molnarkares/blackmagic/README

See https://github.com/blacksphere/blackmagic/wiki
