molnarkares/blackmagic/hardware/contrib/lyorak/Parts.md

Ref Name|Qty|Component|Value|Package|Order ID|
| --- | --- | --- | --- | --- | --- |
LED4|1|1206-LED||SML|KP-3216SGD (KIN) RoHS 1206 3.2x1.6mm GRE|
LED2|1|1206-LED||SML|KP-3216ID (KIN) RoHS 1206 3.2x1.6mm RED|
LED1|1|1206-LED||SML|KP-3216YD (KIN) RoHS 1206 3.2x1.6mm YEL|
LED0|1|1206-LED||SML|KP-3216YD (KIN) RoHS 1206 3.2x1.6mm YEL|
U6|1|66226-006||CON6_1X6_U_FCI||
J13|1|5103309-1||con10_2X5_S4||
Q2|1|ABM3-8||SM|ABM3-8.000MHZ-D2Y-T|
C18|1|CAPACITOR-1206|1u|1206-CAP|CC1206KKX7R7BB105 (YAG) RoHS 1uF 10% 16V X7R|
C13|1|CAPACITOR-1206|4u7|1206-CAP|CL31B475KAHNNNE (SAM) RoHS 4.7uF 10% 25V|
C16|1|CAPACITOR-1206|10n|1206-CAP|CC1206KRX7R9BB104|
C21|1|CAPACITOR-1206|18p|1206-CAP|CL31C180JBCNNNC (SAM) RoHS 18pF 5% 50V NP0|
C20|1|CAPACITOR-1206|18p|1206-CAP|CL31C180JBCNNNC (SAM) RoHS 18pF 5% 50V NP0|
C15|1|CAPACITOR-1206|100n|1206-CAP|CC1206KRX7R9BB104|
C10|1|CAPACITOR-1206|100n|1206-CAP|CC1206KRX7R9BB104|
C12|1|CAPACITOR-1206|100n|1206-CAP|CC1206KRX7R9BB104|
C14|1|CAPACITOR-1206|100n|1206-CAP|CC1206KRX7R9BB104|
C6|1|CAPACITOR-1206|100n|1206-CAP|CC1206KRX7R9BB104|
C2|1|CAPACITOR-1206|100n|1206-CAP|CC1206KRX7R9BB104|
C1|1|CAPACITOR-1206|100n|1206-CAP|CC1206KRX7R9BB104|
J5|1|CONN_3-1|CONN_3-1|SIP1X3_100||
U2|1|IRLML5103TRPBF||SOT-23-L|SI2307CDS-T1-GE3 (VIS) RoHS SOT-23|
U3|1|LP5951MF-3.3||MF05A|LP5951MF-3.3|
J3|1|MINIJTAG||SM||
R23|1|RESISTOR-1206|1K5|1206-RES|CR-06JL7---1K5 (VIK) RoHS 1K50 5%|
R26|1|RESISTOR-1206|4k7|1206-RES|CR-06JL7---4K7 (VIK) RoHS 4K70 5%|
R1|1|RESISTOR-1206|4k7|1206-RES|CR-06JL7---4K7 (VIK) RoHS 4K70 5%|
R24|1|RESISTOR-1206|10k|1206-RES|CR-06JL7---10K (VIK) RoHS 10K0 5%|
R25|1|RESISTOR-1206|10k|1206-RES|CR-06JL7---10K (VIK) RoHS 10K0 5%|
R27|1|RESISTOR-1206|10k|1206-RES|CR-06JL7---10K (VIK) RoHS 10K0 5%|
R3|1|RESISTOR-1206|10k|1206-RES|CR-06JL7---10K (VIK) RoHS 10K0 5%|
R18|1|RESISTOR-1206|22R|1206-RES|CR-06JL7---22R (VIK) RoHS 22R0 5%|
R20|1|RESISTOR-1206|22R|1206-RES|CR-06JL7---22R (VIK) RoHS 22R0 5%|
R6|1|RESISTOR-1206|120R|1206-RES|CR-06JL7--120R (VIK) RoHS 120R 5%|
R15|1|RESISTOR-1206|390R|1206-RES|CR-06JL7--390R (VIK) RoHS 390R 5%|
R12|1|RESISTOR-1206|390R|1206-RES|CR-06JL7--390R (VIK) RoHS 390R 5%|
R14|1|RESISTOR-1206|390R|1206-RES|CR-06JL7--390R (VIK) RoHS 390R 5%|
R13|1|RESISTOR-1206|390R|1206-RES|CR-06JL7--390R (VIK) RoHS 390R 5%|
SW1|1|SMT2PSWITCH||Q_SIL|DTSM-32S-B|
SW2|1|SMT2PSWITCH||Q_SIL|DTSM-32S-B|
U4|1|SN65HV232||sm|SN65HVD232QD|
JP1|1|SQ_JMP-0402|0/DNP|0402-SQJMP|on PCB|
U5|1|STM32-C-64|STM32F105RCT6|LQFP64|STM32F105RCT6|
U1|1|TXS0108EPWRG4||PW20-L|TXS0108EPWR|
USB|1|ZX62-B-5PA|ZX62-B-5PA|ZX62-B-5PA|ZX62D-B-5PA8|
