molnarkares/blackmagic/hardware/contrib/lyorak/blackmagic_lyorak.pdf

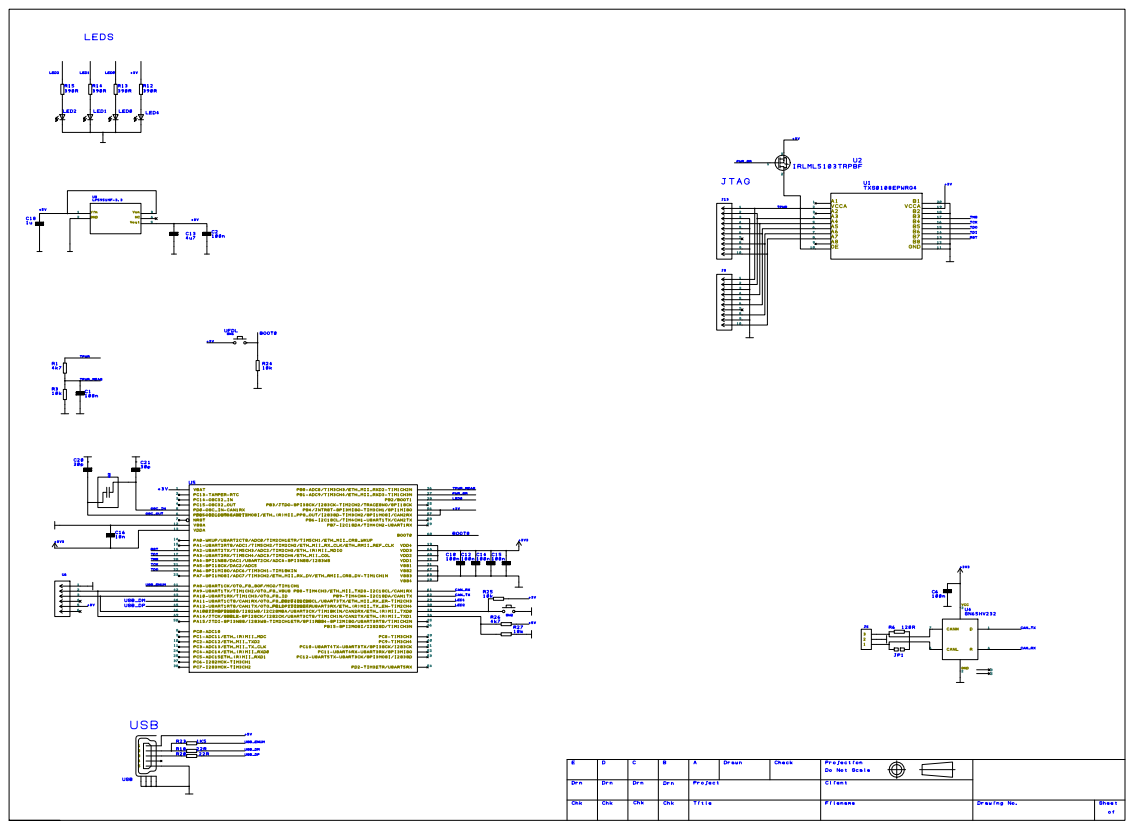
[picture p4: page 1]
