molnarkares/blackmagic/(list of files, drawings)

Other design files:
hardware/contrib/lyorak/blackmagic.pcb
