molnarkares/blackmagic/src/platforms/f4discovery/platform.h

/*
 * This file is part of the Black Magic Debug project.
 *
 * Copyright (C) 2011  Black Sphere Technologies Ltd.
 * Written by Gareth McMullin <gareth@blacksphere.co.nz>
 *
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
 * You should have received a copy of the GNU General Public License
 * along with this program.  If not, see <http://www.gnu.org/licenses/>.
 */

/* This file implements the platform specific functions for the STM32
 * implementation.
 */
#ifndef __PLATFORM_H
#define __PLATFORM_H

#include <stdint.h>
#include <libopencm3/cm3/common.h>
#include <libopencm3/stm32/f4/memorymap.h>
#include <libopencm3/stm32/f4/gpio.h>
#include <libopencm3/usb/usbd.h>

#include <setjmp.h>
#include <alloca.h>

#include "gdb_packet.h"

#define INLINE_GPIO
#define CDCACM_PACKET_SIZE 	64
#define PLATFORM_HAS_TRACESWO
#define BOARD_IDENT       "Black Magic Probe (F4Discovery), (Firmware 1.5" VERSION_SUFFIX ", build " BUILDDATE ")"
#define BOARD_IDENT_DFU   "Black Magic (Upgrade) for F4Discovery, (Firmware 1.5" VERSION_SUFFIX ", build " BUILDDATE ")"
#define DFU_IDENT         "Black Magic Firmware Upgrade (F4Discovery"
#define DFU_IFACE_STRING  "@Internal Flash   /0x08000000/1*016Ka,3*016Kg,1*064Kg,7*128Kg"

extern usbd_device *usbdev;
#define CDCACM_GDB_ENDPOINT	1
#define CDCACM_UART_ENDPOINT	3

/* Important pin mappings for STM32 implementation:
 *
 * LED0 = 	PD12	(Green  LED : Running)
 * LED1 = 	PD13	(Orange LED : Idle)
 * LED2 = 	PD12	(Red LED    : Error)
 * LED3 = 	PD15	(Blue LED   : Bootloader active)
 *
 * TPWR = 	XXX (input) -- analogue on mini design ADC1, ch8
 * nTRST = 	PC1
 * SRST_OUT =   PC8
 * TDI = 	PC2
 * TMS = 	PC4 (input for SWDP)
 * TCK = 	PC5/SWCLK
 * TDO = 	PC6 (input for TRACESWO
 * nSRST =
 *
 * USB cable pull-up: PA8
 * USB VBUS detect:  PB13 -- New on mini design.
 *                           Enable pull up for compatibility.
 * Force DFU mode button: PB12
 */

/* Hardware definitions... */
#define JTAG_PORT 	GPIOC
#define TDI_PORT	JTAG_PORT
#define TMS_PORT	JTAG_PORT
#define TCK_PORT	JTAG_PORT
#define TDO_PORT	GPIOC
#define TDI_PIN		GPIO2
#define TMS_PIN		GPIO4
#define TCK_PIN		GPIO5
#define TDO_PIN		GPIO6

#define SWDIO_PORT 	JTAG_PORT
#define SWCLK_PORT 	JTAG_PORT
#define SWDIO_PIN	TMS_PIN
#define SWCLK_PIN	TCK_PIN

#define TRST_PORT	GPIOC
#define TRST_PIN	GPIO1
#define SRST_PORT	GPIOC
#define SRST_PIN	GPIO8

#define LED_PORT	GPIOD
#define LED_PORT_UART	GPIOD
#define LED_UART	GPIO12
#define LED_IDLE_RUN	GPIO13
#define LED_ERROR	GPIO14
#define LED_BOOTLOADER	GPIO15

#define TMS_SET_MODE() \
	gpio_mode_setup(TMS_PORT, GPIO_MODE_OUTPUT, \
	                GPIO_PUPD_NONE, TMS_PIN);
#define SWDIO_MODE_FLOAT() \
	gpio_mode_setup(SWDIO_PORT, GPIO_MODE_INPUT, \
	                GPIO_PUPD_NONE, SWDIO_PIN);

#define SWDIO_MODE_DRIVE() \
	gpio_mode_setup(SWDIO_PORT, GPIO_MODE_OUTPUT, \
	                GPIO_PUPD_NONE, SWDIO_PIN);


#define USB_DRIVER      stm32f107_usb_driver
#define USB_IRQ         NVIC_OTG_FS_IRQ
#define USB_ISR         otg_fs_isr
/* Interrupt priorities.  Low numbers are high priority.
 * For now USART1 preempts USB which may spin while buffer is drained.
 * TIM3 is used for traceswo capture and must be highest priority.
 */
#define IRQ_PRI_USB		(2 << 4)
#define IRQ_PRI_USBUSART	(1 << 4)
#define IRQ_PRI_USBUSART_TIM	(3 << 4)
#define IRQ_PRI_TRACE		(0 << 4)

#define USBUSART USART3
#define USBUSART_CR1 USART3_CR1
#define USBUSART_IRQ NVIC_USART3_IRQ
#define USBUSART_CLK RCC_USART3
#define USBUSART_TX_PORT GPIOD
#define USBUSART_TX_PIN  GPIO8
#define USBUSART_RX_PORT GPIOD
#define USBUSART_RX_PIN  GPIO9
#define USBUSART_ISR usart3_isr
#define USBUSART_TIM TIM4
#define USBUSART_TIM_CLK_EN() rcc_periph_clock_enable(RCC_TIM4)
#define USBUSART_TIM_IRQ NVIC_TIM4_IRQ
#define USBUSART_TIM_ISR tim4_isr

#define UART_PIN_SETUP() do { \
	gpio_mode_setup(USBUSART_TX_PORT, GPIO_MODE_AF, GPIO_PUPD_NONE, \
	                USBUSART_TX_PIN); \
	gpio_mode_setup(USBUSART_RX_PORT, GPIO_MODE_AF, GPIO_PUPD_NONE, \
	                USBUSART_RX_PIN); \
	gpio_set_af(USBUSART_TX_PORT, GPIO_AF7, USBUSART_TX_PIN); \
	gpio_set_af(USBUSART_RX_PORT, GPIO_AF7, USBUSART_RX_PIN); \
    } while(0)

#define TRACE_TIM TIM3
#define TRACE_TIM_CLK_EN() rcc_periph_clock_enable(RCC_TIM3)
#define TRACE_IRQ   NVIC_TIM3_IRQ
#define TRACE_ISR   tim3_isr

#define DEBUG(...)

extern uint8_t running_status;
extern volatile uint32_t timeout_counter;

extern jmp_buf fatal_error_jmpbuf;

extern const char *morse_msg;

#define gpio_set_val(port, pin, val) do {	\
	if(val)					\
		gpio_set((port), (pin));	\
	else					\
		gpio_clear((port), (pin));	\
} while(0)

#define SET_RUN_STATE(state)	{running_status = (state);}
#define SET_IDLE_STATE(state)	{gpio_set_val(LED_PORT, LED_IDLE_RUN, state);}
#define SET_ERROR_STATE(state)	{gpio_set_val(LED_PORT, LED_ERROR, state);}

#define PLATFORM_SET_FATAL_ERROR_RECOVERY()	{setjmp(fatal_error_jmpbuf);}
#define PLATFORM_FATAL_ERROR(error)	{ 		\
	if(running_status) gdb_putpacketz("X1D");	\
		else gdb_putpacketz("EFF");		\
	running_status = 0;				\
	target_list_free();				\
	morse("TARGET LOST.", 1);			\
	longjmp(fatal_error_jmpbuf, (error));		\
}

int platform_init(void);
void morse(const char *msg, char repeat);
const char *platform_target_voltage(void);
void platform_delay(uint32_t delay);
static inline int platform_hwversion(void)
{
	return 0;
}

/* <cdcacm.c> */
void cdcacm_init(void);
/* Returns current usb configuration, or 0 if not configured. */
int cdcacm_get_config(void);
int cdcacm_get_dtr(void);

/* <platform.h> */
void uart_usb_buf_drain(uint8_t ep);

/* Use newlib provided integer only stdio functions */
#define sscanf siscanf
#define sprintf siprintf
#define vasprintf vasiprintf

#ifdef INLINE_GPIO
static inline void _gpio_set(uint32_t gpioport, uint16_t gpios)
{
	GPIO_BSRR(gpioport) = gpios;
	GPIO_BSRR(gpioport) = gpios;
}
#define gpio_set _gpio_set

static inline void _gpio_clear(uint32_t gpioport, uint16_t gpios)
{
	GPIO_BSRR(gpioport) = gpios<<16;
	GPIO_BSRR(gpioport) = gpios<<16;
}
#define gpio_clear _gpio_clear

static inline uint16_t _gpio_get(uint32_t gpioport, uint16_t gpios)
{
	return (uint16_t)GPIO_IDR(gpioport) & gpios;
}
#define gpio_get _gpio_get
#endif

#endif

#define disconnect_usb() do {usbd_disconnect(usbdev,1); nvic_disable_irq(USB_IRQ);} while(0)
void assert_boot_pin(void);
#define setup_vbus_irq()
