molnarkares/blackmagic/src/platforms/stm32/dfucore.c

/*
 * This file is part of the Black Magic Debug project.
 *
 * Copyright (C) 2013 Gareth McMullin <gareth@blacksphere.co.nz>
 *
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
 * You should have received a copy of the GNU General Public License
 * along with this program.  If not, see <http://www.gnu.org/licenses/>.
 */

#include "platform.h"

#include <string.h>
#include <libopencm3/stm32/flash.h>
#include <libopencm3/usb/usbd.h>
#include <libopencm3/usb/dfu.h>

#include "usbdfu.h"

usbd_device *usbdev;
/* We need a special large control buffer for this device: */
uint8_t usbd_control_buffer[2048];

static uint32_t max_address;

static enum dfu_state usbdfu_state = STATE_DFU_IDLE;

static char *get_dev_unique_id(char *serial_no);

static struct {
	uint8_t buf[sizeof(usbd_control_buffer)];
	uint16_t len;
	uint32_t addr;
	uint16_t blocknum;
} prog;

const struct usb_device_descriptor dev = {
	.bLength = USB_DT_DEVICE_SIZE,
	.bDescriptorType = USB_DT_DEVICE,
	.bcdUSB = 0x0200,
	.bDeviceClass = 0,
	.bDeviceSubClass = 0,
	.bDeviceProtocol = 0,
	.bMaxPacketSize0 = 64,
	.idVendor = 0x1D50,
	.idProduct = 0x6017,
	.bcdDevice = 0x0100,
	.iManufacturer = 1,
	.iProduct = 2,
	.iSerialNumber = 3,
	.bNumConfigurations = 1,
};

const struct usb_dfu_descriptor dfu_function = {
	.bLength = sizeof(struct usb_dfu_descriptor),
	.bDescriptorType = DFU_FUNCTIONAL,
	.bmAttributes = USB_DFU_CAN_DOWNLOAD | USB_DFU_WILL_DETACH,
	.wDetachTimeout = 255,
	.wTransferSize = 2048,
	.bcdDFUVersion = 0x011A,
};

const struct usb_interface_descriptor iface = {
	.bLength = USB_DT_INTERFACE_SIZE,
	.bDescriptorType = USB_DT_INTERFACE,
	.bInterfaceNumber = 0,
	.bAlternateSetting = 0,
	.bNumEndpoints = 0,
	.bInterfaceClass = 0xFE, /* Device Firmware Upgrade */
	.bInterfaceSubClass = 1,
	.bInterfaceProtocol = 2,

	/* The ST Microelectronics DfuSe application needs this string.
	 * The format isn't documented... */
	.iInterface = 4,

	.extra = &dfu_function,
	.extralen = sizeof(dfu_function),
};

const struct usb_interface ifaces[] = {{
	.num_altsetting = 1,
	.altsetting = &iface,
}};

const struct usb_config_descriptor config = {
	.bLength = USB_DT_CONFIGURATION_SIZE,
	.bDescriptorType = USB_DT_CONFIGURATION,
	.wTotalLength = 0,
	.bNumInterfaces = 1,
	.bConfigurationValue = 1,
	.iConfiguration = 0,
	.bmAttributes = 0xC0,
	.bMaxPower = 0x32,

	.interface = ifaces,
};

static char serial_no[9];

/*static const char *usb_strings[] = {
	"Lyorak",
	BOARD_IDENT_DFU,
	"Papilot",
	serial_no,
	//This string is used by ST Microelectronics' DfuSe utility
	"@Internal Flash   /0x08000000/4*002Ka,124*002Kg"
};*/

static const char *usb_strings[] = {
	"Black Sphere Technologies",
	BOARD_IDENT_DFU,
	serial_no,
	// This string is used by ST Microelectronics' DfuSe utility
	DFU_IFACE_STRING
};

static const char *usb_strings_upd[] = {
	"Black Sphere Technologies",
	BOARD_IDENT_UPD,
	serial_no,
	/* This string is used by ST Microelectronics' DfuSe utility */
	UPD_IFACE_STRING,
};

static uint32_t get_le32(const void *vp)
{
	const uint8_t *p = vp;
	return ((uint32_t)p[3] << 24) + ((uint32_t)p[2] << 16) + (p[1] << 8) + p[0];
}

static uint8_t usbdfu_getstatus(uint32_t *bwPollTimeout)
{
	switch(usbdfu_state) {
	case STATE_DFU_DNLOAD_SYNC:
		usbdfu_state = STATE_DFU_DNBUSY;
		*bwPollTimeout = dfu_poll_timeout(prog.buf[0],
					get_le32(prog.buf + 1),
					prog.blocknum);
		return DFU_STATUS_OK;

	case STATE_DFU_MANIFEST_SYNC:
		/* Device will reset when read is complete */
		usbdfu_state = STATE_DFU_MANIFEST;
		return DFU_STATUS_OK;

	default:
		return DFU_STATUS_OK;
	}
}

static void
usbdfu_getstatus_complete(usbd_device *dev, struct usb_setup_data *req)
{
	(void)req;

	switch(usbdfu_state) {
	case STATE_DFU_DNBUSY:

		flash_unlock();
		if(prog.blocknum == 0) {
			uint32_t addr = get_le32(prog.buf + 1);
			if ((addr < app_address) || (addr >= max_address)) {
				flash_lock();
				usbd_ep_stall_set(dev, 0, 1);
				return;
			}
			switch(prog.buf[0]) {
			case CMD_ERASE:
				dfu_check_and_do_sector_erase(addr);
			case CMD_SETADDR:
				prog.addr = addr;
			}
		} else {
			uint32_t baseaddr = prog.addr +
				((prog.blocknum - 2) *
					dfu_function.wTransferSize);
			dfu_flash_program_buffer(baseaddr, prog.buf, prog.len);
		}
		flash_lock();

		/* We jump straight to dfuDNLOAD-IDLE,
		 * skipping dfuDNLOAD-SYNC
		 */
		usbdfu_state = STATE_DFU_DNLOAD_IDLE;
		return;

	case STATE_DFU_MANIFEST:
		dfu_detach();
		return; /* Will never return */
	default:
		return;
	}
}

static int usbdfu_control_request(usbd_device *dev,
		struct usb_setup_data *req, uint8_t **buf, uint16_t *len,
		void (**complete)(usbd_device *dev, struct usb_setup_data *req))
{
	(void)dev;

	if((req->bmRequestType & 0x7F) != 0x21)
		return 0; /* Only accept class request */

	switch(req->bRequest) {
	case DFU_DNLOAD:
		if((len == NULL) || (*len == 0)) {
			usbdfu_state = STATE_DFU_MANIFEST_SYNC;
			return 1;
		} else {
			/* Copy download data for use on GET_STATUS */
			prog.blocknum = req->wValue;
			prog.len = *len;
			memcpy(prog.buf, *buf, *len);
			usbdfu_state = STATE_DFU_DNLOAD_SYNC;
			return 1;
		}
	case DFU_CLRSTATUS:
		/* Clear error and return to dfuIDLE */
		if(usbdfu_state == STATE_DFU_ERROR)
			usbdfu_state = STATE_DFU_IDLE;
		return 1;
	case DFU_ABORT:
		/* Abort returns to dfuIDLE state */
		usbdfu_state = STATE_DFU_IDLE;
		return 1;
	case DFU_UPLOAD:
		/* Upload not supported for now */
		return 0;
	case DFU_GETSTATUS: {
		uint32_t bwPollTimeout = 0; /* 24-bit integer in DFU class spec */

		(*buf)[0] = usbdfu_getstatus(&bwPollTimeout);
		(*buf)[1] = bwPollTimeout & 0xFF;
		(*buf)[2] = (bwPollTimeout >> 8) & 0xFF;
		(*buf)[3] = (bwPollTimeout >> 16) & 0xFF;
		(*buf)[4] = usbdfu_state;
		(*buf)[5] = 0;	/* iString not used here */
		*len = 6;

		*complete = usbdfu_getstatus_complete;

		return 1;
		}
	case DFU_GETSTATE:
		/* Return state with no state transision */
		*buf[0] = usbdfu_state;
		*len = 1;
		return 1;
	}

	return 0;
}

void dfu_init(const usbd_driver *driver, dfu_mode_t mode)
{
	get_dev_unique_id(serial_no);

	usbdev = usbd_init(driver, &dev, &config,
			   (mode == DFU_MODE)?usb_strings:usb_strings_upd, 4,
			   usbd_control_buffer, sizeof(usbd_control_buffer));

	usbd_register_control_callback(usbdev,
				USB_REQ_TYPE_CLASS | USB_REQ_TYPE_INTERFACE,
				USB_REQ_TYPE_TYPE | USB_REQ_TYPE_RECIPIENT,
				usbdfu_control_request);
}

void dfu_main(void)
{
	while (1) {
		//gpio_set(GPIOB, GPIO10);
		usbd_poll(usbdev);
		//gpio_clear(GPIOB, GPIO10);
	}
}

static char *get_dev_unique_id(char *s)
{
#if defined(STM32F4) || defined(STM32F2)
#	define UNIQUE_SERIAL_R 0x1FFF7A10
#	define FLASH_SIZE_R    0x1fff7A22
#elif defined(STM32F3)
#	define UNIQUE_SERIAL_R 0x1FFFF7AC
#	define FLASH_SIZE_R    0x1fff77cc
#elif defined(STM32L1)
#	define UNIQUE_SERIAL_R 0x1ff80050
#	define FLASH_SIZE_R    0x1FF8004C
#else
#	define UNIQUE_SERIAL_R 0x1FFFF7E8;
#	define FLASH_SIZE_R    0x1ffff7e0
#endif
	volatile uint32_t *unique_id_p = (volatile uint32_t *)UNIQUE_SERIAL_R;
	uint32_t unique_id = *unique_id_p +
			*(unique_id_p + 1) +
			*(unique_id_p + 2);
	int i;

	/* Calculated the upper flash limit from the exported data
	   in theparameter block*/
	max_address = (*(uint32_t *) FLASH_SIZE_R) <<10;
	/* Fetch serial number from chip's unique ID */
	for(i = 0; i < 8; i++) {
		s[7-i] = ((unique_id >> (4*i)) & 0xF) + '0';
	}
	for(i = 0; i < 8; i++)
		if(s[i] > '9')
			s[i] += 'A' - '9' - 1;
	s[8] = 0;

	return s;
}
