molnarkares/blackmagic/src/include/adiv5.h

/*
 * This file is part of the Black Magic Debug project.
 *
 * Copyright (C) 2011  Black Sphere Technologies Ltd.
 * Written by Gareth McMullin <gareth@blacksphere.co.nz>
 *
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
 * You should have received a copy of the GNU General Public License
 * along with this program.  If not, see <http://www.gnu.org/licenses/>.
 */

#ifndef __ADIV5_H
#define __ADIV5_H

#include "general.h"
#include "jtag_scan.h"
#include "target.h"

/* ADIv5 DP Register addresses */
#define ADIV5_DP_IDCODE		0x0
#define ADIV5_DP_ABORT		0x0
#define ADIV5_DP_CTRLSTAT	0x4
#define ADIV5_DP_SELECT		0x8
#define ADIV5_DP_RDBUFF		0xC

/* AP Abort Register (ABORT) */
/* Bits 31:5 - Reserved */
#define ADIV5_DP_ABORT_ORUNERRCLR	(1 << 4)
#define ADIV5_DP_ABORT_WDERRCLR		(1 << 3)
#define ADIV5_DP_ABORT_STKERRCLR	(1 << 2)
#define ADIV5_DP_ABORT_STKCMPCLR	(1 << 1)
/* Bits 5:1 - SW-DP only, reserved in JTAG-DP */
#define ADIV5_DP_ABORT_DAPABORT		(1 << 0)

/* Control/Status Register (CTRLSTAT) */
#define ADIV5_DP_CTRLSTAT_CSYSPWRUPACK	(1u << 31)
#define ADIV5_DP_CTRLSTAT_CSYSPWRUPREQ	(1u << 30)
#define ADIV5_DP_CTRLSTAT_CDBGPWRUPACK	(1u << 29)
#define ADIV5_DP_CTRLSTAT_CDBGPWRUPREQ	(1u << 28)
#define ADIV5_DP_CTRLSTAT_CDBGRSTACK	(1u << 27)
#define ADIV5_DP_CTRLSTAT_CDBGRSTREQ	(1u << 26)
/* Bits 25:24 - Reserved */
/* Bits 23:12 - TRNCNT */
#define ADIV5_DP_CTRLSTAT_TRNCNT
/* Bits 11:8 - MASKLANE */
#define ADIV5_DP_CTRLSTAT_MASKLANE
/* Bits 7:6 - Reserved in JTAG-DP */
#define ADIV5_DP_CTRLSTAT_WDATAERR	(1u << 7)
#define ADIV5_DP_CTRLSTAT_READOK	(1u << 6)
#define ADIV5_DP_CTRLSTAT_STICKYERR	(1u << 5)
#define ADIV5_DP_CTRLSTAT_STICKYCMP	(1u << 4)
#define ADIV5_DP_CTRLSTAT_TRNMODE_MASK	(3u << 2)
#define ADIV5_DP_CTRLSTAT_STICKYORUN	(1u << 1)
#define ADIV5_DP_CTRLSTAT_ORUNDETECT	(1u << 0)


/* ADIv5 MEM-AP Registers */
#define ADIV5_AP_CSW		0x00
#define ADIV5_AP_TAR		0x04
/* 0x08 - Reserved */
#define ADIV5_AP_DRW		0x0C
#define ADIV5_AP_DB(x)		(0x10 + (4*(x)))
/* 0x20:0xF0 - Reserved */
#define ADIV5_AP_CFG		0xF4
#define ADIV5_AP_BASE		0xF8
#define ADIV5_AP_IDR		0xFC

/* AP Control and Status Word (CSW) */
#define ADIV5_AP_CSW_DBGSWENABLE	(1u << 31)
/* Bits 30:24 - Prot, Implementation defined, for Cortex-M3: */
#define ADIV5_AP_CSW_MASTERTYPE_DEBUG	(1u << 29)
#define ADIV5_AP_CSW_HPROT1		(1u << 25)
#define ADIV5_AP_CSW_SPIDEN		(1u << 23)
/* Bits 22:12 - Reserved */
/* Bits 11:8 - Mode, must be zero */
#define ADIV5_AP_CSW_TRINPROG		(1u << 7)
#define ADIV5_AP_CSW_DEVICEEN		(1u << 6)
#define ADIV5_AP_CSW_ADDRINC_NONE	(0u << 4)
#define ADIV5_AP_CSW_ADDRINC_SINGLE	(1u << 4)
#define ADIV5_AP_CSW_ADDRINC_PACKED	(2u << 4)
#define ADIV5_AP_CSW_ADDRINC_MASK	(3u << 4)
/* Bit 3 - Reserved */
#define ADIV5_AP_CSW_SIZE_BYTE		(0u << 0)
#define ADIV5_AP_CSW_SIZE_HALFWORD	(1u << 0)
#define ADIV5_AP_CSW_SIZE_WORD		(2u << 0)
#define ADIV5_AP_CSW_SIZE_MASK		(7u << 0)

/* Constants to make RnW and APnDP parameters more clear in code */
#define ADIV5_LOW_WRITE		0
#define ADIV5_LOW_READ		1
#define ADIV5_LOW_DP		0
#define ADIV5_LOW_AP		1

/* Try to keep this somewhat absract for later adding SW-DP */
typedef struct ADIv5_DP_s {
	int refcnt;

	uint32_t idcode;

	bool allow_timeout;

	void (*dp_write)(struct ADIv5_DP_s *dp, uint8_t addr, uint32_t value);
	uint32_t (*dp_read)(struct ADIv5_DP_s *dp, uint8_t addr);

	uint32_t (*error)(struct ADIv5_DP_s *dp);

	uint32_t (*low_access)(struct ADIv5_DP_s *dp, uint8_t APnDP, uint8_t RnW,
			uint8_t addr, uint32_t value);

	union {
		jtag_dev_t *dev;
		uint8_t fault;
	};
} ADIv5_DP_t;

static inline void adiv5_dp_write(ADIv5_DP_t *dp, uint8_t addr, uint32_t value)
{
	dp->dp_write(dp, addr, value);
}

static inline uint32_t adiv5_dp_read(ADIv5_DP_t *dp, uint8_t addr)
{
	return dp->dp_read(dp, addr);
}

static inline uint32_t adiv5_dp_error(ADIv5_DP_t *dp)
{
	return dp->error(dp);
}

static inline uint32_t adiv5_dp_low_access(struct ADIv5_DP_s *dp, uint8_t APnDP,
					uint8_t RnW, uint8_t addr, uint32_t value)
{
	return dp->low_access(dp, APnDP, RnW, addr, value);
}

typedef struct ADIv5_AP_s {
	int refcnt;

	ADIv5_DP_t *dp;
	uint8_t apsel;

	uint32_t idr;
	uint32_t cfg;
	uint32_t base;
	uint32_t csw;

	void *priv;
	void (*priv_free)(void *);
} ADIv5_AP_t;

void adiv5_dp_init(ADIv5_DP_t *dp);

void adiv5_dp_ref(ADIv5_DP_t *dp);
void adiv5_ap_ref(ADIv5_AP_t *ap);
void adiv5_dp_unref(ADIv5_DP_t *dp);
void adiv5_ap_unref(ADIv5_AP_t *ap);

void adiv5_dp_write_ap(ADIv5_DP_t *dp, uint8_t addr, uint32_t value);
uint32_t adiv5_dp_read_ap(ADIv5_DP_t *dp, uint8_t addr);

uint32_t adiv5_ap_mem_read(ADIv5_AP_t *ap, uint32_t addr);
void adiv5_ap_mem_write(ADIv5_AP_t *ap, uint32_t addr, uint32_t value);
uint16_t adiv5_ap_mem_read_halfword(ADIv5_AP_t *ap, uint32_t addr);
void adiv5_ap_mem_write_halfword(ADIv5_AP_t *ap, uint32_t addr, uint16_t value);
uint8_t adiv5_ap_mem_read_byte(ADIv5_AP_t *ap, uint32_t addr);
void adiv5_ap_mem_write_byte(ADIv5_AP_t *ap, uint32_t addr, uint8_t value);

void adiv5_ap_write(ADIv5_AP_t *ap, uint8_t addr, uint32_t value);
uint32_t adiv5_ap_read(ADIv5_AP_t *ap, uint8_t addr);

void adiv5_jtag_dp_handler(jtag_dev_t *dev);
int adiv5_swdp_scan(void);

static inline ADIv5_AP_t *adiv5_target_ap(target *target)
{
	return target->priv;
}

#endif
