molnarkares/blackmagic/scripts/stm32_mem.py

#!/usr/bin/env python
#
# stm32_mem.py: STM32 memory access using USB DFU class
# Copyright (C) 2011  Black Sphere Technologies 
# Written by Gareth McMullin <gareth@blacksphere.co.nz>
#
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
from time import sleep
import struct
from sys import stdout, argv

import argparse
import usb
import dfu

CMD_GETCOMMANDS =            0x00
CMD_SETADDRESSPOINTER =      0x21
CMD_ERASE =                  0x41

def stm32_erase(dev, addr):
	erase_cmd = struct.pack("<BL", CMD_ERASE, addr)
	dev.download(0, erase_cmd)
	while True:
		status = dev.get_status()
		if status.bState == dfu.STATE_DFU_DOWNLOAD_BUSY:
			sleep(status.bwPollTimeout / 1000.0)
		if status.bState == dfu.STATE_DFU_DOWNLOAD_IDLE:
			break

def stm32_write(dev, data):
	dev.download(2, data)
	while True:
		status = dev.get_status()
		if status.bState == dfu.STATE_DFU_DOWNLOAD_BUSY:
			sleep(status.bwPollTimeout / 1000.0)
		if status.bState == dfu.STATE_DFU_DOWNLOAD_IDLE:
			break
	
def stm32_manifest(dev):
	dev.download(0, "")
	while True:
		try:
			status = dev.get_status()
		except:
			return
		sleep(status.bwPollTimeout / 1000.0)
		if status.bState == dfu.STATE_DFU_MANIFEST:
			break

if __name__ == "__main__":
	print
	print "USB Device Firmware Upgrade - Host Utility -- version 1.2"
	print "Copyright (C) 2011  Black Sphere Technologies"
	print "License GPLv3+: GNU GPL version 3 or later <http://gnu.org/licenses/gpl.html>"
	print

	parser = argparse.ArgumentParser()
	parser.add_argument("progfile", help="Binary file to program")
	parser.add_argument("-s", "--serial_target", help="Match Serial Number")
	args = parser.parse_args()
	devs = dfu.finddevs()
	if not devs:
		print "No devices found!"
		exit(-1)

	for dev in devs:
		dfudev = dfu.dfu_device(*dev)
		man = dfudev.handle.getString(dfudev.dev.iManufacturer, 30)
		product = dfudev.handle.getString(dfudev.dev.iProduct, 64)
		serial_no = dfudev.handle.getString(dfudev.dev.iSerialNumber, 30)
		if args.serial_target:
			if man == "Black Sphere Technologies" and serial_no ==  args.serial_target: break
			if man == "STMicroelectronics" and serial_no == args.serial_target: break
			if man == " Lyorak Kaoa v2" and serial_no == args.serial_target: break

                else:
			break
#			if man == "Black Sphere Technologies": break
#			if man == "STMicroelectronics": break
#			if man == " Lyorak Kaoa v2": break

	print "Device %s: ID %04x:%04x %s - %s\n\tSerial %s" % (
                dfudev.dev.filename, dfudev.dev.idVendor,
                dfudev.dev.idProduct, man, product, serial_no)

	if args.serial_target and serial_no !=  args.serial_target:
                print "Serial number doesn't match!\n"
                exit(-2)
	try:
		state = dfudev.get_state()
	except:
		print "Failed to read device state! Assuming APP_IDLE"
		state = dfu.STATE_APP_IDLE
	if state == dfu.STATE_APP_IDLE:
		dfudev.detach()
		print "Run again to upgrade firmware."
		exit(0)

	dfudev.make_idle()

	bin = open(args.progfile, "rb").read()

	if "F4" in product:
		addr = 0x8004000
	else:
		addr = 0x8002000
	while bin:
		print ("Programming memory at 0x%08X\r" % addr),
		stdout.flush()
		try:
			stm32_erase(dfudev, addr)
                except:
			print "\nErase Timed out\n"
			break
		stm32_write(dfudev, bin[:2048])

		bin = bin[2048:]
		addr += 2048

	stm32_manifest(dfudev)

	print "\nAll operations complete!\n"
