molnarkares/blackmagic/(commit log)

2014-01-01 added files for the Lyorak BMAGICK variant. It is using STM32F105
2014-01-01 sector size is 2K on STM32F105, adjusted accordingly
2014-01-02 usb config changed for STM32F105
2014-01-06 Lyorak board variant
    Blackmagic mini with the following changes:
    * uses STM32F105 instead of STM32F103
    * added one CAN channel
    * PCB re-designed for 1206 passive components to allow manual assembly
    [blackmagic.pcb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]
2014-01-09 added description
    PDF schematic, and readme added
2014-01-15 Update README.md
    minor update on readme to clarify PCB assembly
2014-01-22 Pin 1 marked on PCB
2014-01-22 updated readme
    Added switches, LEDs, connector pinouts
2014-03-05 new dia /jpeg
    added description for the pin headers and led's
    ned jpeg created (instead of old bmp)
